WanNJ/Wearable-Dance-Party/flashing-jacket/flashing-jacket.ino

#include "src/classifiers/mode_classifier.h"
#include "src/classifiers/gesture_classifier.h"
#include "src/classifiers/signal_classifier.h"

#include "src/leds/led_strip.h"
#include "src/leds/led_grid.h"

#include "src/leds/signals/brake_signal.h"
#include "src/leds/signals/idle_signal.h"
#include "src/leds/signals/direction_signal.h"

#include "src/sensors/imu.h"



//#define DEBUG


#define DELAY 100





// PINS
#define PIN_STRIP1 12
#define PIN_STRIP2 11

#define LSM9DS1_SCK 24
#define LSM9DS1_MISO 22
#define LSM9DS1_MOSI 23

#define LSM9DS1_XGCS1 5 // CHIP SELECT IMU 1
#define LSM9DS1_XGCS2 6 // CHIP SELECT IMU 2
#define LSM9DS1_XGCS3 10 // CHIP SELECT IMU 3







// LEDS

#define SIMULATION_LED



// Grid
#define NB_STRIPS 10
#define NB_LEDS 10


#ifndef SIMULATION_LED

// Leds per strips
#define NUMPIXELS1      20
#define NUMPIXELS2      77

LedStrip ledStrip1(NUMPIXELS1, 0, PIN_STRIP1);
LedStrip ledStrip2(NUMPIXELS2, NUMPIXELS1, PIN_STRIP2);
LedStrip *ledStrips[2] = {&ledStrip1, &ledStrip2};

LedGrid ledGrid(ledStrips, 2);

#else

#include "src/leds/led_strip_simu.h"

LedStripSimu ledStrip1(NB_LEDS, 0 * NB_LEDS, 0);
LedStripSimu ledStrip2(NB_LEDS, 1 * NB_LEDS, 0);
LedStripSimu ledStrip3(NB_LEDS, 2 * NB_LEDS, 0);
LedStripSimu ledStrip4(NB_LEDS, 3 * NB_LEDS, 0);
LedStripSimu ledStrip5(NB_LEDS, 4 * NB_LEDS, 0);
LedStripSimu ledStrip6(NB_LEDS, 5 * NB_LEDS, 0);
LedStripSimu ledStrip7(NB_LEDS, 6 * NB_LEDS, 0);
LedStripSimu ledStrip8(NB_LEDS, 7 * NB_LEDS, 0);
LedStripSimu ledStrip9(NB_LEDS, 8 * NB_LEDS, 0);
LedStripSimu ledStrip10(NB_LEDS, 9 * NB_LEDS, 0);

LedStrip *ledStrips[NB_STRIPS] = {
  &ledStrip1, 
  &ledStrip2, 
  &ledStrip3,
  &ledStrip4,
  &ledStrip5,
  &ledStrip6,
  &ledStrip7,
  &ledStrip8,
  &ledStrip9,
  &ledStrip10,
};

LedGrid ledGrid(ledStrips, NB_STRIPS);

#endif






// IMU

// #define SIMULATION_IMU

#ifndef SIMULATION_IMU

//IMU torsoImu(LSM9DS1_SCK, LSM9DS1_MISO, LSM9DS1_MOSI, LSM9DS1_XGCS1);
//IMU armImu(LSM9DS1_SCK, LSM9DS1_MISO, LSM9DS1_MOSI, LSM9DS1_XGCS2);
IMU forearmImu(LSM9DS1_SCK, LSM9DS1_MISO, LSM9DS1_MOSI, LSM9DS1_XGCS3);

#else

#include "src/sensors/imu_simu.h"

IMUSimu torsoImu(LSM9DS1_SCK, LSM9DS1_MISO, LSM9DS1_MOSI, LSM9DS1_XGCS1);
IMUSimu armImu(LSM9DS1_SCK, LSM9DS1_MISO, LSM9DS1_MOSI, LSM9DS1_XGCS2);
IMUSimu forearmImu(LSM9DS1_SCK, LSM9DS1_MISO, LSM9DS1_MOSI, LSM9DS1_XGCS3);

#endif

IMU::Data torsoData;
IMU::Data armData;
IMU::Data forearmData;





// SIGNALS
IdleSignal idleSignal(NB_STRIPS, NB_LEDS);
BrakeSignal brakeSignal(NB_STRIPS, NB_LEDS);
LeftSignal leftSignal(NB_STRIPS, NB_LEDS);
RightSignal rightSignal(NB_STRIPS, NB_LEDS);







// CLASSIFIERS

//#define SIMULATION_CLASSIFIERS


#ifndef SIMULATION_CLASSIFIERS

ModeClassifier modeClassifier;
SignalClassifier signalClassifier;
GestureClassifier gestureClassifier;

#else

#include "src/classifiers/mode_classifier_simu.h"
ModeClassifierSimu modeClassifier;

#include "src/classifiers/signal_classifier_simu.h"
SignalClassifierSimu signalClassifier;

#include "src/classifiers/gesture_classifier_simu.h"
GestureClassifierSimu gestureClassifier;

#endif

#define SWITCH_PERIOD 2000

bool gesture = false;
bool switchMode = false;
uint32_t switchTimer;
ModeClassifier::State mode = ModeClassifier::State::BIKE;

SignalClassifier::State bikeState = SignalClassifier::State::IDLE;





// MUSIC

// Exclude music mode for demo purpose.
#define EXCLUSE_MUSIC

#ifndef EXCLUSE_MUSIC

#include "src/sensors/microphone.h"
#include "src/leds/signals/music_signal.h"

// sample rate for the input
#define SAMPLE_RATE 2000

// size of the FFT to compute
#define FFT_SIZE 128

// create an FFT analyzer to be used with the I2S input
FFTAnalyzer fftAnalyzer(FFT_SIZE);

Microphone microphone(FFT_SIZE, NB_STRIPS, NB_LEDS);

MusicSignal musicSignal(NB_STRIPS, NB_LEDS, &microphone);

#endif






void setup() {
  // Open serial communications and wait for port to open:
  // A baud rate of 115200 is used instead of 9600 for a faster data rate
  // on non-native USB ports
  Serial.begin(115200);
  while (!Serial) {
    delay(1); // wait for serial port to connect. Needed for native USB port only
  }

  //torsoImu.begin();
  delay(10);
  //armImu.begin();
  delay(10);
  Serial.println("IMU begin");
  if (!forearmImu.begin()) {
    Serial.println("Error with IMU");
  }
  Serial.println("IMU begin OK");

#ifndef EXCLUSE_MUSIC
  microphone.begin(SAMPLE_RATE);
#endif
  ledGrid.begin();
  ledGrid.setSignal(&idleSignal);
}

void sense() {
  //torsoImu.read(&torsoData);
  //armImu.read(&armData);
  forearmImu.read(&forearmData);
}

void analyze() {
  gesture = gestureClassifier.classify(forearmData);

  // Detect gesture
  
  if (gesture) {
    Serial.println("Detected gesture");
    switchMode = modeClassifier.classify(forearmData);

    if(switchMode){
      if (millis() - switchTimer >= SWITCH_PERIOD) {
        Serial.println("Detected switch");
        switchTimer = millis();
        switch(mode) {
          case ModeClassifier::State::BIKE:
            mode = ModeClassifier::State::MUSIC;
            break;
          case ModeClassifier::State::MUSIC:
            mode = ModeClassifier::State::BIKE;
            break;
        }
      }
    } 
    else {
      if (mode == ModeClassifier::State::BIKE) {
        bikeState = signalClassifier.classify(forearmData);
      }
    }
  }
  else {
    if (mode == ModeClassifier::State::BIKE) {
        bikeState = SignalClassifier::State::IDLE;
      }
  }
  
  // Update signal

  switch(mode) {
    case ModeClassifier::State::BIKE:
#ifdef DEBUG
      Serial.print("BIKE\t");
#endif
      switch(bikeState) {
        case SignalClassifier::State::IDLE:
          Serial.println("Idle");
          ledGrid.setSignal(&idleSignal);
          break;
        case SignalClassifier::State::STOP:
#ifdef DEBUG
          Serial.println("Stop");
#endif
          ledGrid.setSignal(&brakeSignal);
          break;
        case SignalClassifier::State::LEFT:
#ifdef DEBUG
          Serial.println("Left");
#endif
          ledGrid.setSignal(&leftSignal);
          break;
        case SignalClassifier::State::RIGHT:
#ifdef DEBUG
          Serial.println("Right");
#endif
          ledGrid.setSignal(&rightSignal);
          break;
      }
      break;
    case ModeClassifier::State::MUSIC:
#ifdef DEBUG
      Serial.println("MUSIC");
#endif
#ifndef EXCLUSE_MUSIC
      ledGrid.setSignal(&musicSignal);
#else
      ledGrid.setSignal(NULL);
#endif
      break;
  }
}

void actuate() {
  ledGrid.refresh();
}


void loop() {
  sense();
  analyze();
  actuate();

  delay(DELAY);
}
